nevzathipertek/color_sensor/pcb_and_electronic_design/colorSensor01-6.jpg

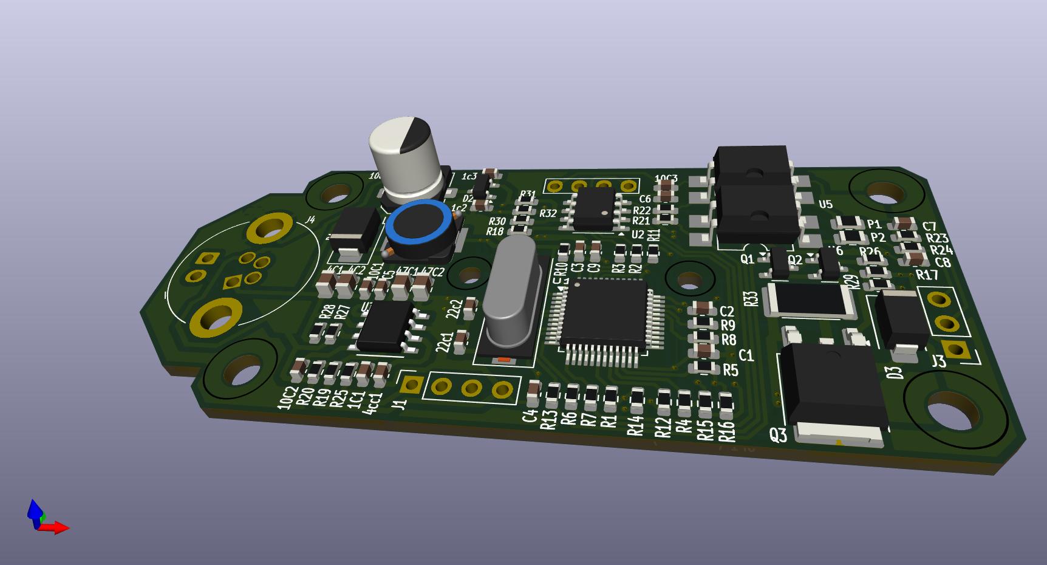
pcb_and_electronic_design/colorSensor01-6.jpg
