nevzathipertek/color_sensor/pcb_and_electronic_design/back2.jpg

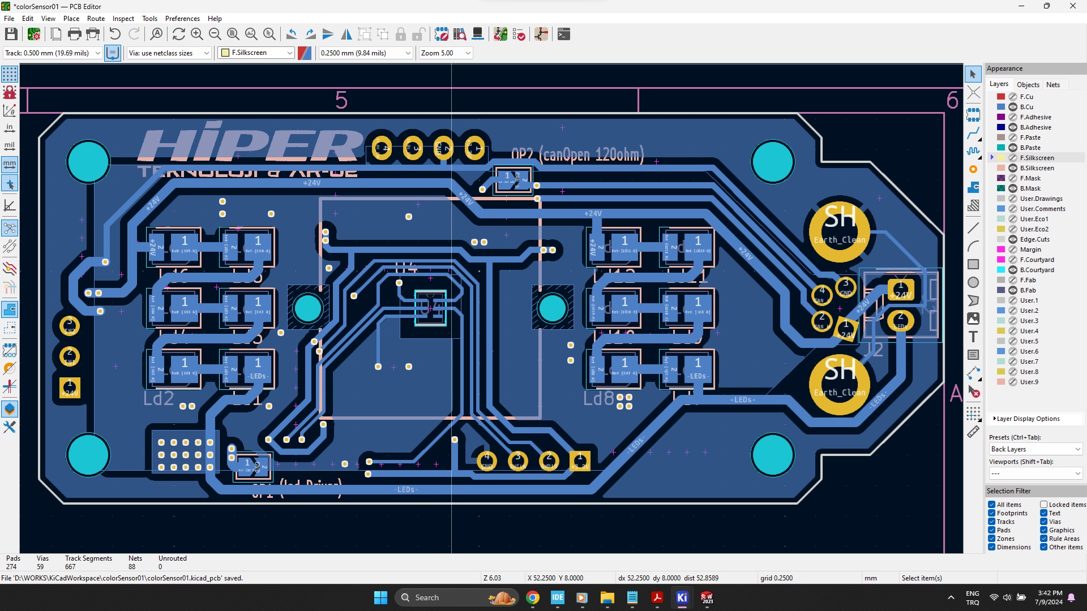
pcb_and_electronic_design/back2.jpg
