nevzathipertek/color_sensor/pcb_and_electronic_design/colorSensor01-2.jpg

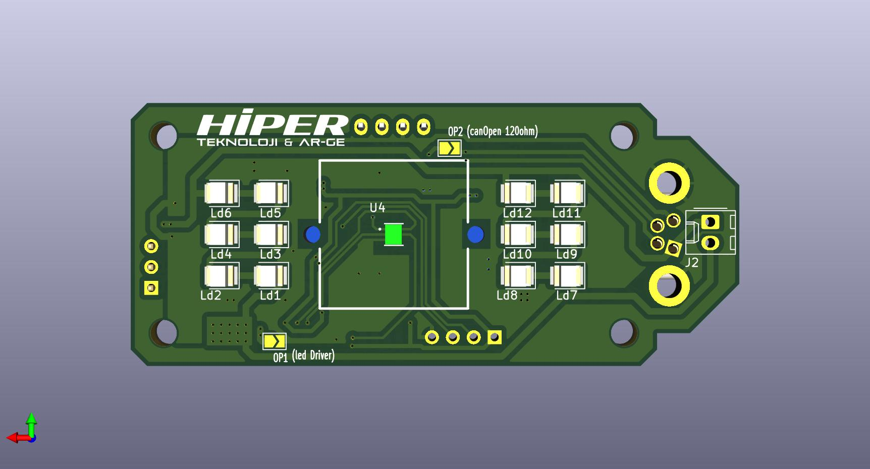
pcb_and_electronic_design/colorSensor01-2.jpg
