nevzathipertek/color_sensor/pcb_and_electronic_design/colorSensor01-4.jpg

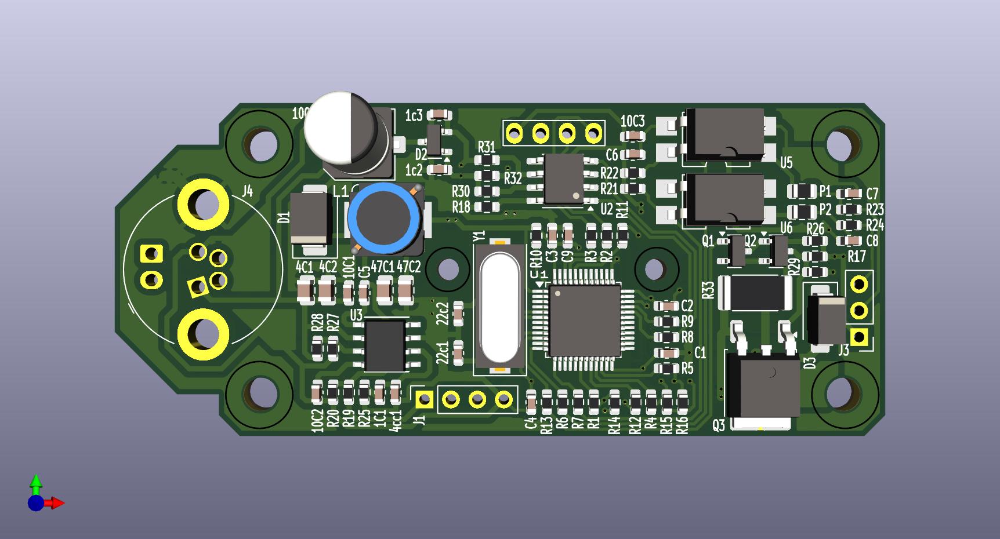
pcb_and_electronic_design/colorSensor01-4.jpg
