nevzathipertek/color_sensor/pcb_and_electronic_design/colorSensor01-5.jpg

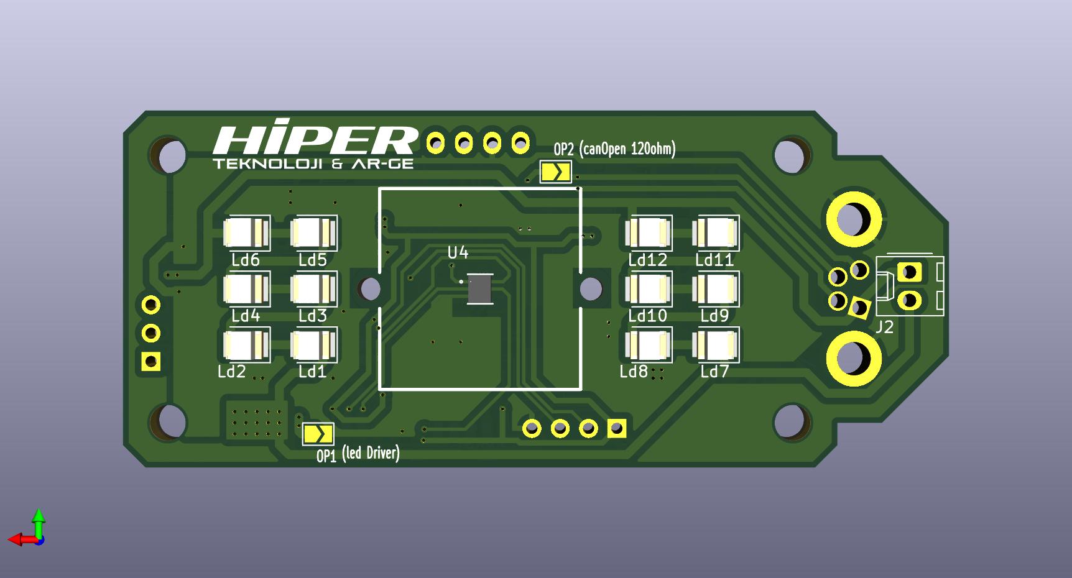
pcb_and_electronic_design/colorSensor01-5.jpg
