nevzathipertek/color_sensor/pcb_and_electronic_design/front1.jpg

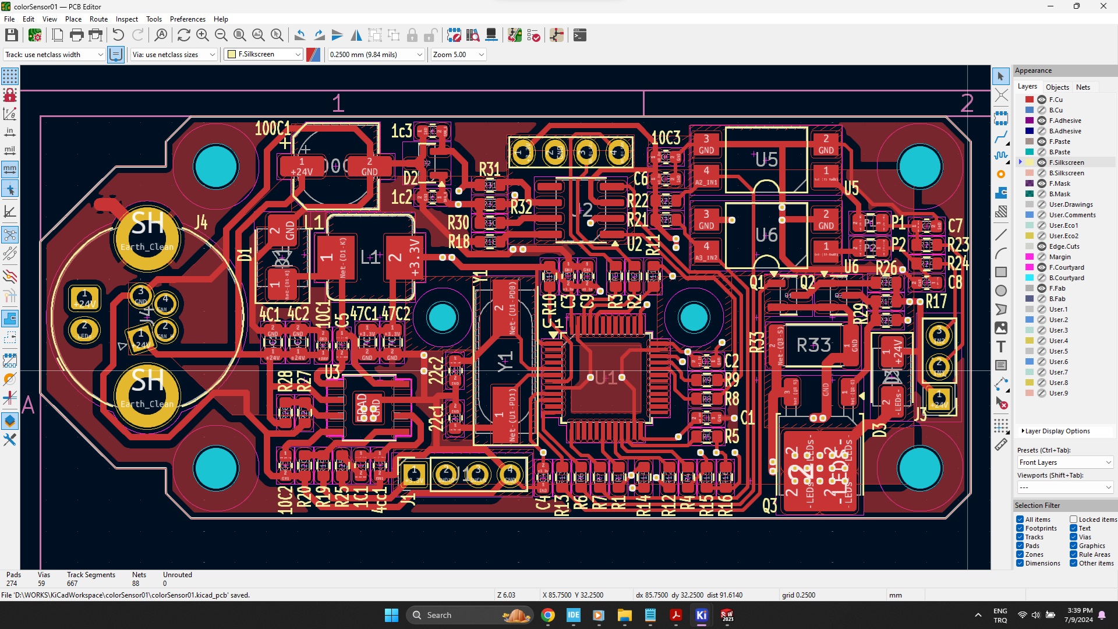
pcb_and_electronic_design/front1.jpg
