nevzathipertek/color_sensor/pcb_and_electronic_design/front3all.jpg

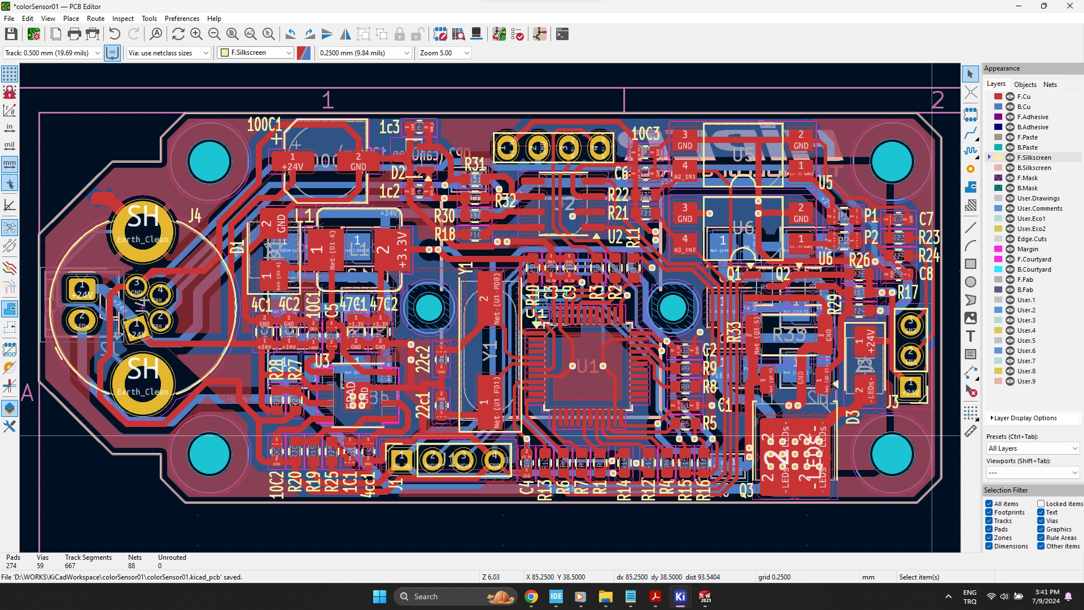
pcb_and_electronic_design/front3all.jpg
