nevzathipertek/color_sensor/pcb_and_electronic_design/schematic-colorSensor.jpg

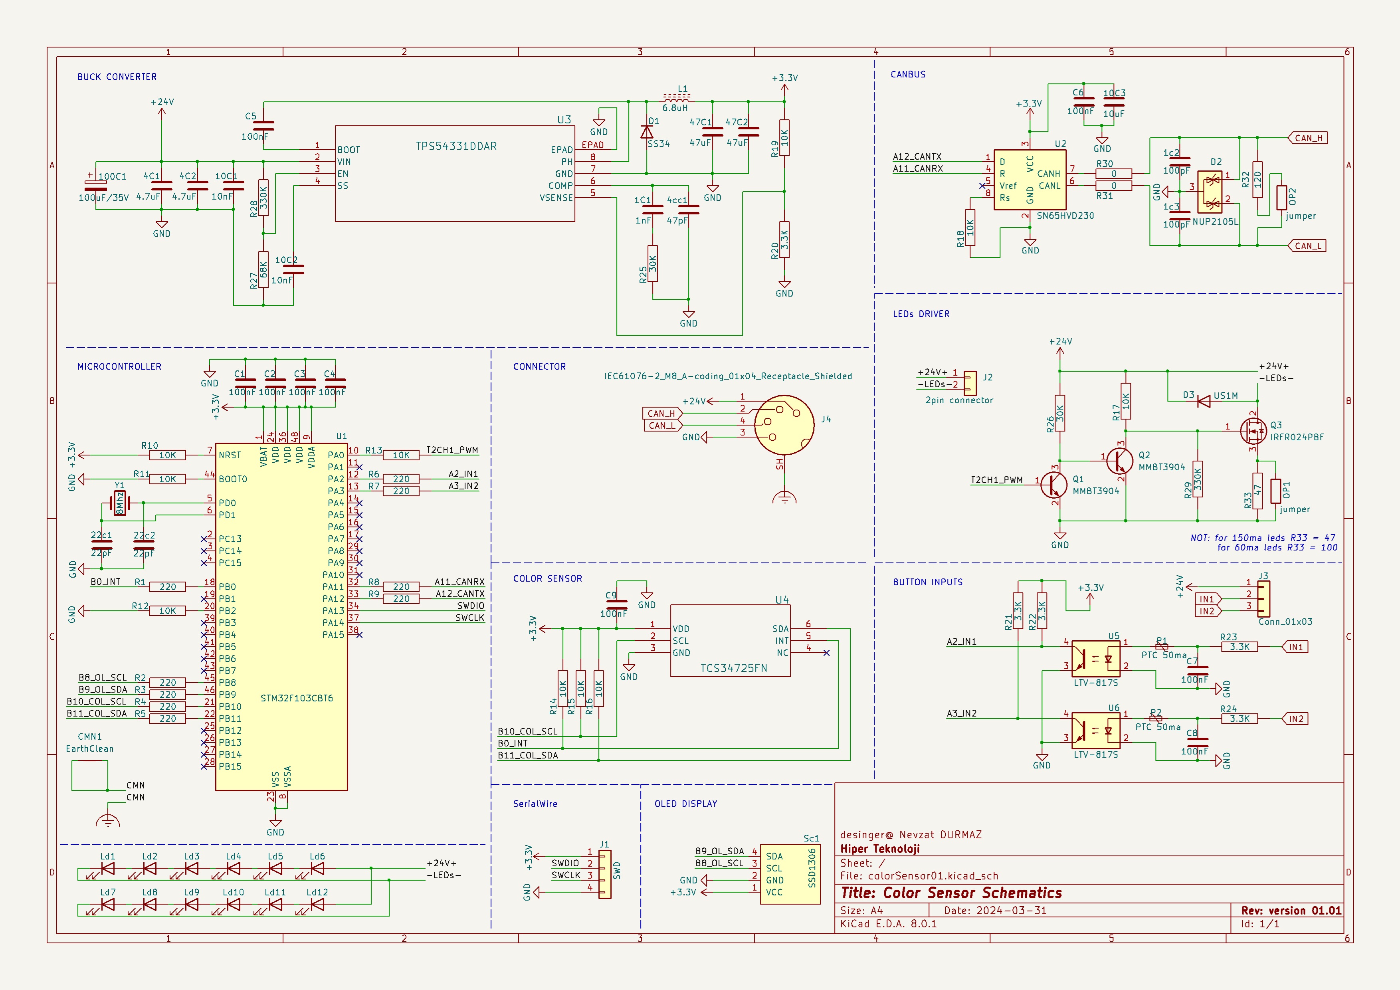
pcb_and_electronic_design/schematic-colorSensor.jpg
