nevzathipertek/color_sensor/solid_modelling/membran.jpg

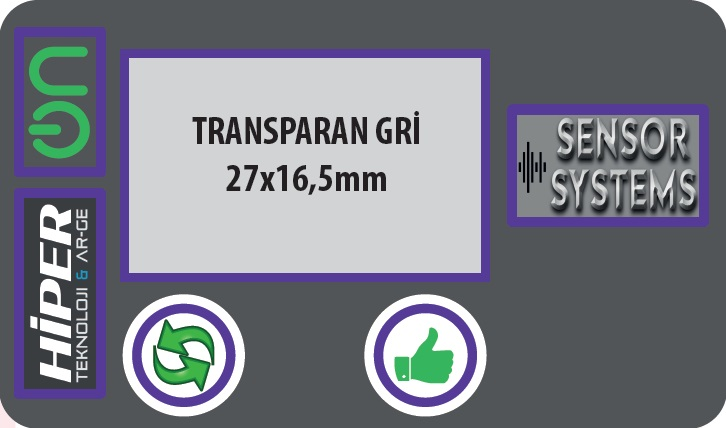
solid_modelling/membran.jpg
