nevzathipertek/color_sensor/pcb_and_electronic_design/colorSensor_BOM.xlsx

Comment | Designator | Footprint | JLCPCB Part #（optional）
PTC 50ma | P2,P1 | Fuse_0805_2012Metric | ptc fuse 50ma
10K | R16,R18,R11,R12,R10,R13,R14,R15,R19,R17 | R_0603_1608Metric
US1M | D3 | D_SMA | Diodes,
3.3K | R24,R20,R23,R21,R22 | R_0603_1608Metric
220 | R4,R3,R1,R6,R8,R5,R9,R2,R7 | R_0603_1608Metric
8Mhz | Y1 | Crystal_SMD_HC49-SD
20pF | 22c1,22c2 | C_0603_1608Metric | 20pF (or 22pF)
100nF | C4,C1,C8,C6,C2,C7,C9,C3,C5 | C_0603_1608Metric
LTV-817S | U6,U5 | SMDIP-4_W9.53mm | LITEON, Optocoupler (or PC817xxx - Diodes Incorporated, SHARP/Socle Technology )
SN65HVD230 | U2 | SOIC-8_3.9x4.9mm_P1.27mm | Texas Instruments,
NUP2105L | D2 | SOT-23 | Onsemi, or Diotec Semiconductor
0 | R31,R30 | R_0603_1608Metric | 0 ohm
TPS54331DDAR | U3 | DDA8_3X2P13-L | Texas Instruments TPS54331DDAR
68K | R27 | R_0603_1608Metric
10nF | 10C1,10C2 | C_0603_1608Metric
MMBT3904 | Q1,Q2 | SOT-23 | Onsemi,
47 | R33 | R_2512_6332Metric
47pF | 4cc1 | C_0603_1608Metric
100pF | 1c2,1c3 | C_0603_1608Metric
6.8uH | L1 | L_Bourns_SRP7028A_7.3x6.6mm | 1A or higher
10uF | 10C3 | C_0603_1608Metric
IRFR024PBF | Q3 | TO-252-2 | Vishay (or Infineon – IRFR540ZTRPBF)
STM32F103CBT6 | U1 | LQFP-48_7x7mm_P0.5mm | must be original ST
47uF | 47C2,47C1 | C_0805_2012Metric
120 | R32 | R_0603_1608Metric
30K | R25,R26 | R_0603_1608Metric
100uF/35V | 100C1 | CP_Elec_6.3x7.7 | 35V ~ 50V
4.7uF | 4C2,4C1 | C_0805_2012Metric
330K | R28,R29 | R_0603_1608Metric
SS34 | D1 | D_SMB
1nF | 1C1 | C_0603_1608Metric
LED | Ld1 – Ld12 | LED_PLCC_2835 | (2835 packet, 2.8V~3.2V, 150~200mA, 60~120degree beam angle) daylight / sunlight – large spectrum
TCS34725FN | U4 | TCS34725FN_AMS | AMS OSRAM
