nevzathipertek/color_sensor/solid_modelling/upCase.SLDPRT

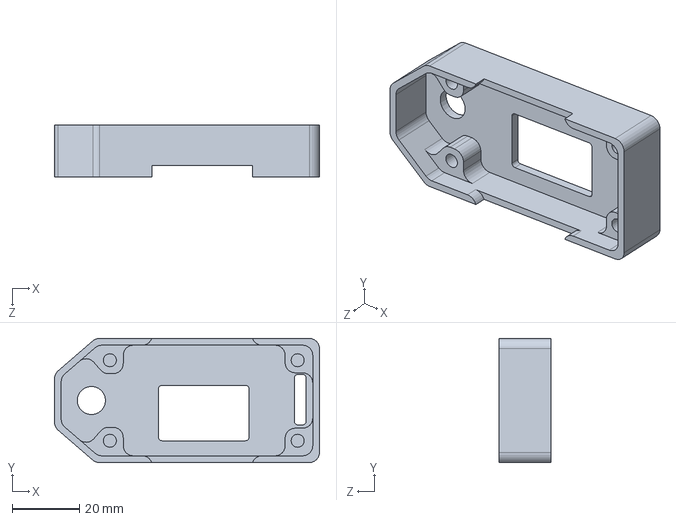
[picture p10: CAD file, 2024-07-17]
solid_modelling/upCase.SLDPRT
79.0 x 37.0 x 15.5 mm
