nevzathipertek/color_sensor/solid_modelling/downCase.SLDPRT

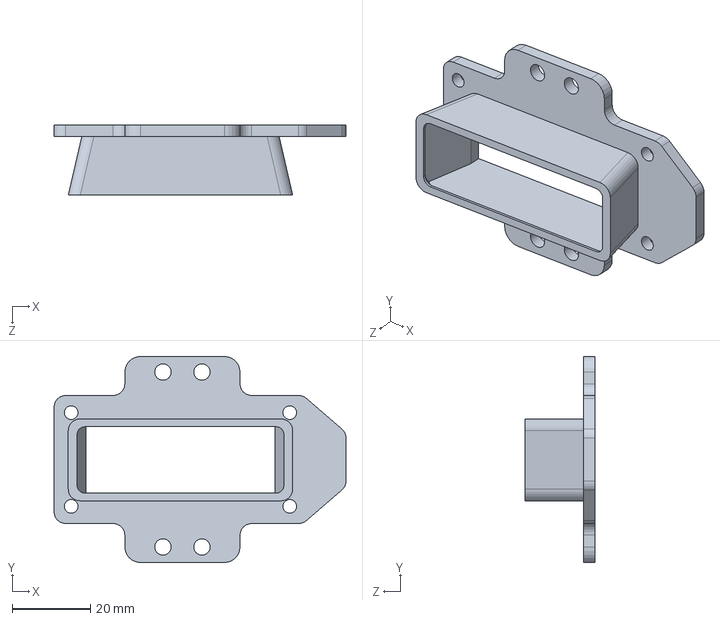
[picture p11: CAD file, 2024-07-17]
solid_modelling/downCase.SLDPRT
74.8 x 52.8 x 18.0 mm
