nevzathipertek/color_sensor/solid_modelling/membranTus.SLDPRT

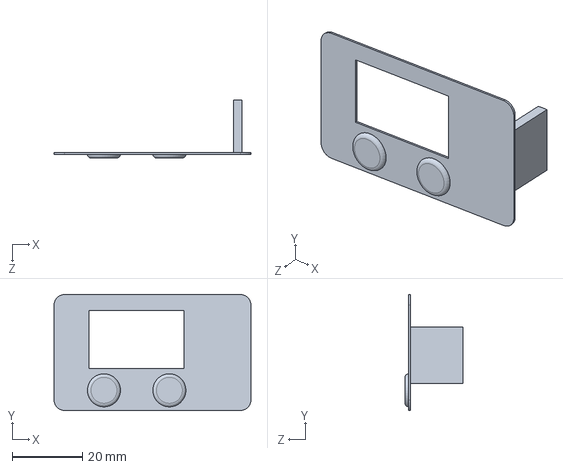
[picture p12: CAD file, 2024-07-17]
solid_modelling/membranTus.SLDPRT
56.0 x 33.0 x 16.5 mm
