nevzathipertek/color_sensor/solid_modelling/colorSensor01.step.SLDASM

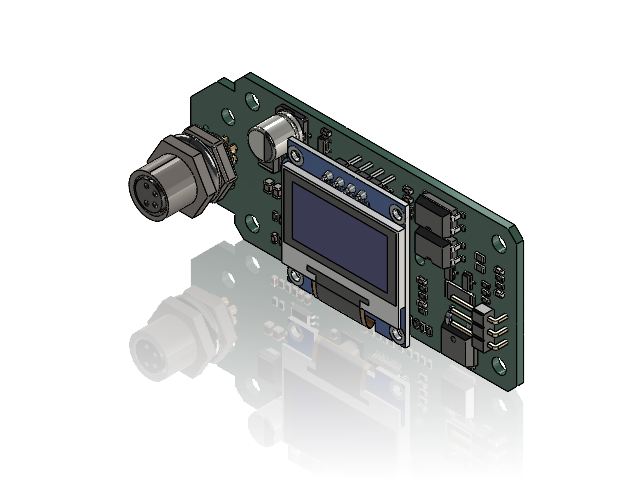
[picture p13: CAD file, 2024-07-17]
solid_modelling/colorSensor01.step.SLDASM
Fuse_0805_2012Metric-0.step x 2
R_0603_1608Metric-1.step x 32
D_SMA-2.step
Crystal_SMD_HC49-SD-3.step
C_0603_1608Metric-4.step x 18
SMDIP_4_W953mm.step x 2
SOIC_8_39x49mm_P127mm.step
SOT_23.step x 3
DDA0008H_ASM.step
R_2512_6332Metric-5.step
Sf___fd_sp.step
connectorFemaleFlange-6.step
PinHeader_1x03_P254mm_Horizontal.step
CQ assembly.step
LQFP_48_7x7mm_P05mm.step
C_0805_2012Metric-7.step x 4
(Unsaved).step
CP_Elec_63x77.step
D_SMB-8.step
LED_1210_3225Metric-9.step x 12
part.step
colorSensor01_PCB.step
