nevzathipertek/color_sensor/(list of files, cad)

Other CAD files:
solid_modelling/colorSensorParts/SMDIP-4_W9.53mm.step.SLDASM
solid_modelling/colorSensorParts/connectorFemaleFlange.step.SLDASM
solid_modelling/colorSensorParts/L_TDK_SLF7032.step.SLDASM
solid_modelling/colorSensorParts/DDA0008H.step.SLDASM
solid_modelling/colorSensorParts/D_SMB.step.SLDASM
solid_modelling/colorSensorParts/LED_1210_3225Metric.step.SLDASM
solid_modelling/colorSensorParts/CQ assembly.step.SLDPRT
solid_modelling/colorSensorParts/R_2512_6332Metric.step.SLDASM
solid_modelling/colorSensorParts/Fuse_0805_2012Metric.step.SLDASM
solid_modelling/colorSensorParts/Crystal_SMD_HC49-SD.step.SLDASM
solid_modelling/colorSensorParts/C_0805_2012Metric.step.SLDASM
solid_modelling/colorSensorParts/OLED-128x64-0.96.step.SLDASM
solid_modelling/colorSensorParts/SOIC-8_3.9x4.9mm_P1.27mm.step.SLDASM
solid_modelling/colorSensorParts/PinHeader_1x03_P2.54mm_Horizontal.step.SLDASM
solid_modelling/colorSensorParts/SOT-23.step.SLDASM
solid_modelling/colorSensorParts/LQFP-48_7x7mm_P0.5mm.step.SLDASM
solid_modelling/colorSensorParts/CP_Elec_6.3x7.7.step.SLDASM
solid_modelling/colorSensorParts/TO-252-2.step.SLDASM
solid_modelling/colorSensorParts/DDA0008H_ASM.step.SLDPRT
solid_modelling/colorSensorParts/R_0603_1608Metric.step.SLDASM
solid_modelling/colorSensorParts/D_SMA.step.SLDASM
solid_modelling/colorSensorParts/C_0603_1608Metric.step.SLDASM
solid_modelling/colorSensorParts/connectorFemaleFlange-6.step.SLDPRT
solid_modelling/colorSensorParts/Crystal_SMD_HC49-SD-3.step.SLDPRT
solid_modelling/colorSensorParts/D_SMA-2.step.SLDPRT
solid_modelling/colorSensorParts/(Unsaved).step.SLDPRT
solid_modelling/colorSensorParts/SMDIP_4_W953mm.step.SLDPRT
solid_modelling/colorSensorParts/Sf___fd_sp.step.SLDPRT
solid_modelling/colorSensorParts/SOIC_8_39x49mm_P127mm.step.SLDPRT
solid_modelling/colorSensorParts/colorSensor01_PCB.step.SLDPRT
solid_modelling/colorSensorParts/D_SMB-8.step.SLDPRT
solid_modelling/colorSensorParts/PinHeader_1x03_P254mm_Horizontal.step.SLDPRT
solid_modelling/colorSensorParts/LQFP_48_7x7mm_P05mm.step.SLDPRT
solid_modelling/colorSensorParts/LED_1210_3225Metric-9.step.SLDPRT
solid_modelling/colorSensorParts/C_0603_1608Metric-4.step.SLDPRT
solid_modelling/colorSensorParts/R_2512_6332Metric-5.step.SLDPRT
solid_modelling/colorSensorParts/Fuse_0805_2012Metric-0.step.SLDPRT
solid_modelling/colorSensorParts/R_0603_1608Metric-1.step.SLDPRT
solid_modelling/colorSensorParts/CP_Elec_63x77.step.SLDPRT
solid_modelling/colorSensorParts/C_0805_2012Metric-7.step.SLDPRT
solid_modelling/colorSensorParts/part.step.SLDPRT
solid_modelling/colorSensorParts/SOT_23.step.SLDPRT
solid_modelling/colorSensorParts/TCS34725FN_AMS.step.SLDASM
solid_modelling/downCase.STL
solid_modelling/upCase.STL
