nevzathipertek/color_sensor/pcb_and_electronic_design/colorSensor01/colorSensor01.kicad_pcb

## KiCad design pcb_and_electronic_design/colorSensor01/colorSensor01.kicad_pcb (2024-07-17)

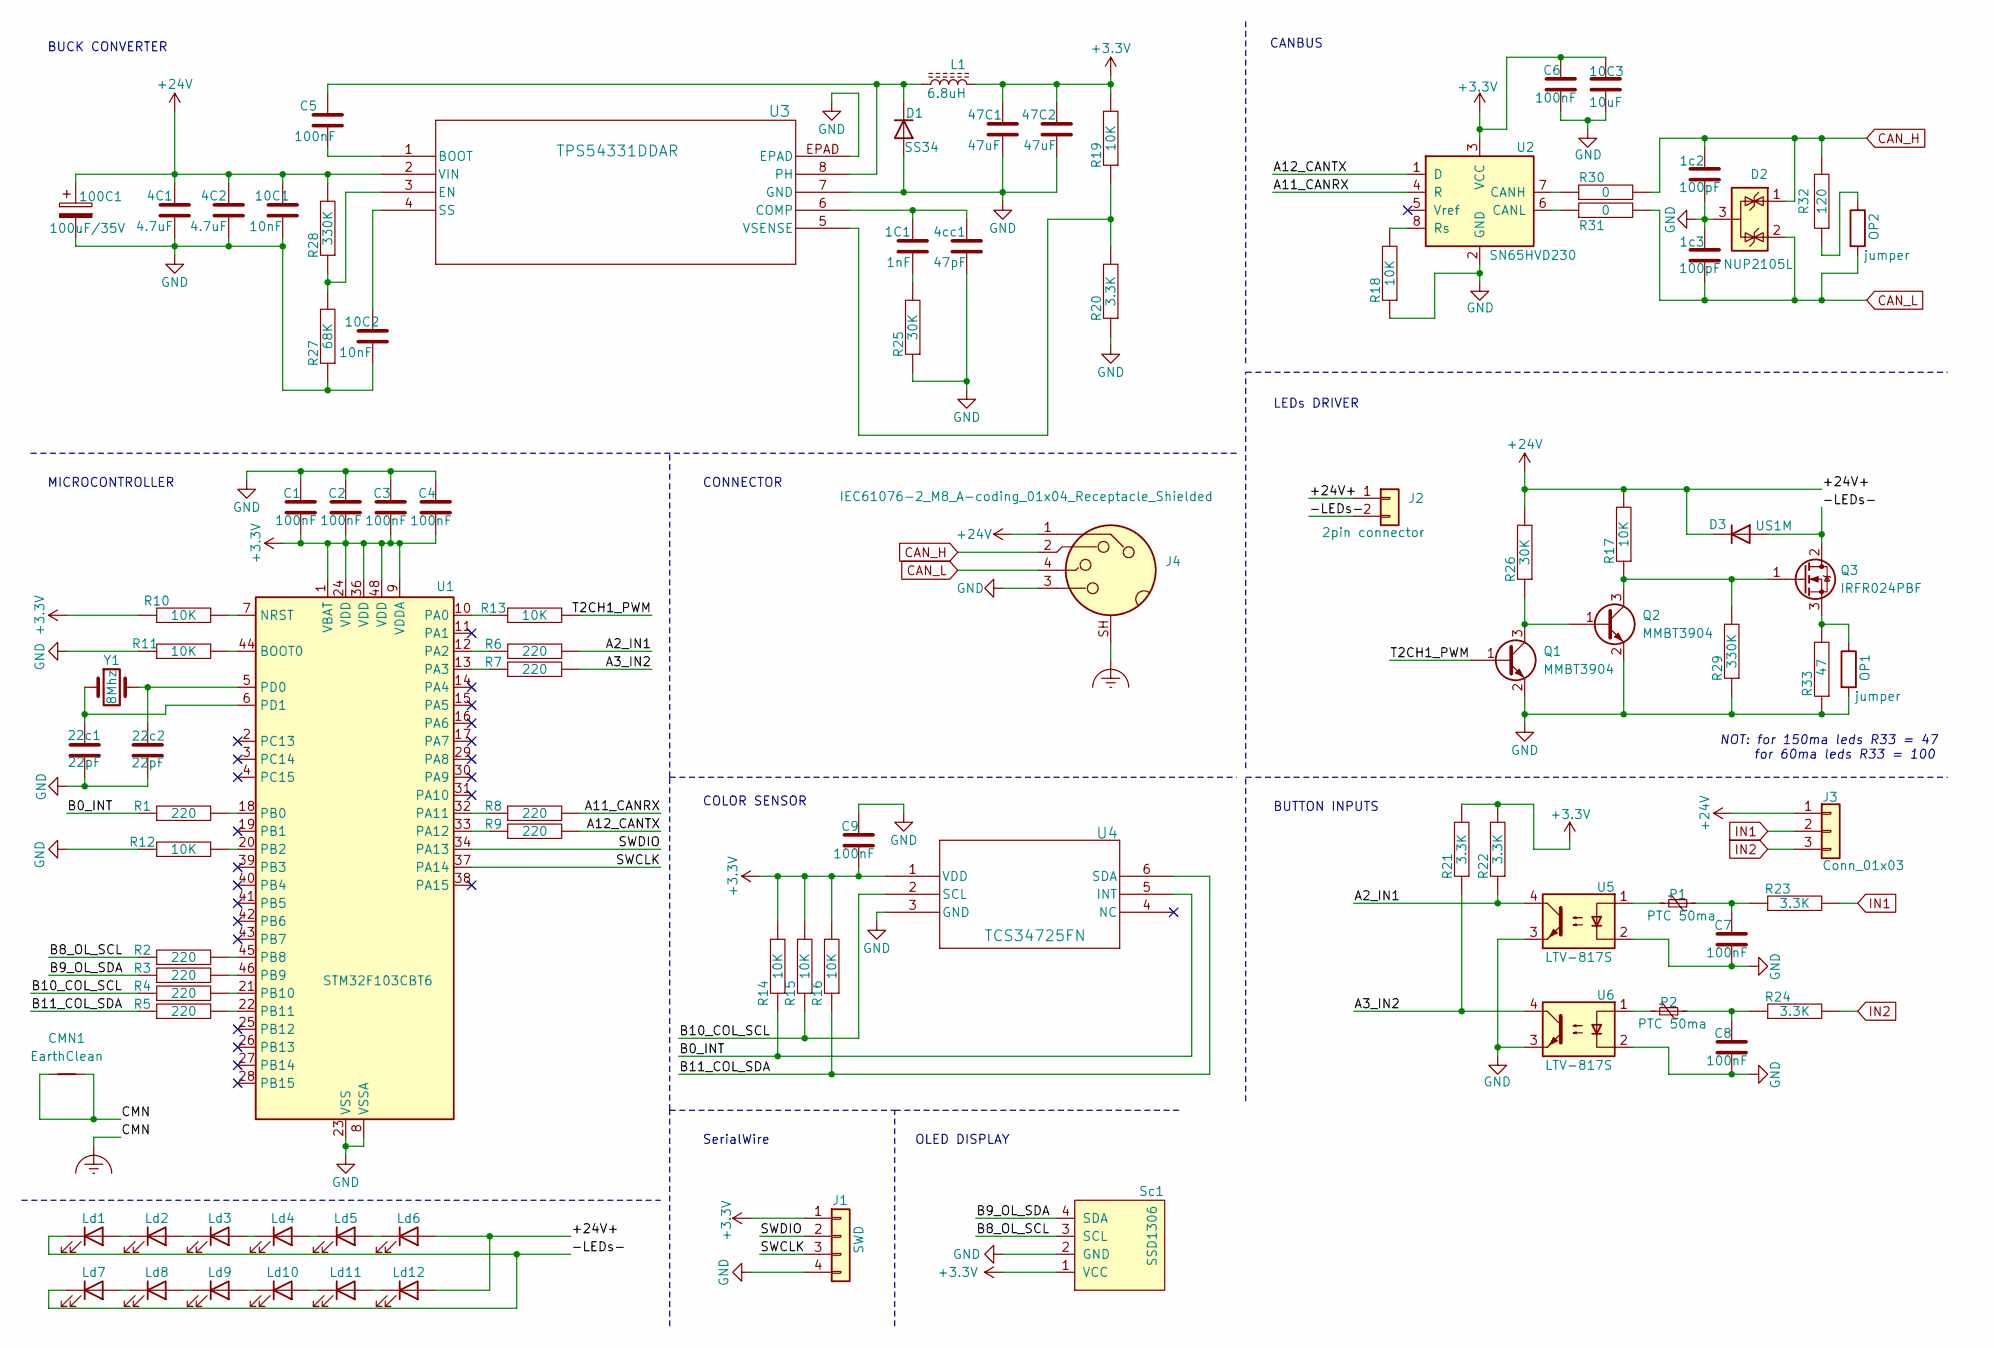
[picture p14: schematic colorSensor01.kicad_sch, Color Sensor Schematics]

Parts:
1C1: 1nF; C_0603_1608Metric
1c2, 1c3: 100pF; C_0603_1608Metric
4C1, 4C2: 4.7uF; C_0805_2012Metric
4cc1: 47pF; C_0603_1608Metric
10C1, 10C2: 10nF; C_0603_1608Metric
10C3: 10uF; C_0603_1608Metric
22c1, 22c2: 22pF; C_0603_1608Metric
47C1, 47C2: 47uF; C_0805_2012Metric
100C1: 100uF/35V; CP_Elec_6.3x7.7
C1, C2, C3, C4, C5, C6, C7, C8, C9: 100nF; C_0603_1608Metric
CMN1: EarthClean; NetTie-2_SMD_Pad0.5mm
D1: SS34; D_SMB
D2: NUP2105L; SOT-23
D3: US1M; D_SMA
J1: SWD; PinSocket_1x04_P2.54mm_Vertical
J2: 2pin connector; Molex_KK-254_AE-6410-02A_1x02_P2.54mm_Vertical
J3: Conn_01x03; PinHeader_1x03_P2.54mm_Vertical
J4: IEC61076-2_M8_A-coding_01x04_Receptacle_Shielded; TE_T4041037041-000_M8_04_Socket_Straight
L1: 6.8uH; L_Bourns_SRP7028A_7.3x6.6mm
Ld1, Ld2, Ld3, Ld4, Ld5, Ld6, Ld7, Ld8, Ld9, Ld10, Ld11, Ld12: LED; LED_PLCC_2835
OP1, OP2: jumper; SolderJumper-2_P1.3mm_Open_TrianglePad1.0x1.5mm
P1, P2: PTC 50ma; Fuse_0805_2012Metric
Q1, Q2: MMBT3904; SOT-23
Q3: IRFR024PBF; TO-252-2
R1, R2, R3, R4, R5, R6, R7, R8, R9: 220; R_0603_1608Metric
R10, R11, R12, R13, R14, R15, R16, R17, R18, R19: 10K; R_0603_1608Metric
R20, R21, R22, R23, R24: 3.3K; R_0603_1608Metric
R25, R26: 30K; R_0603_1608Metric
R27: 68K; R_0603_1608Metric
R28, R29: 330K; R_0603_1608Metric
R30, R31: 0; R_0603_1608Metric
R32: 120; R_0603_1608Metric
R33: 47; R_2512_6332Metric
Sc1: SSD1306; 128x64OLED
U1: STM32F103CBT6; LQFP-48_7x7mm_P0.5mm
U2: SN65HVD230; SOIC-8_3.9x4.9mm_P1.27mm
U3: TPS54331DDAR; DDA8_3X2P13-L
U4: TCS34725FN; TCS34725FN_AMS
U5, U6: LTV-817S; SMDIP-4_W9.53mm
Y1: 8Mhz; Crystal_SMD_HC49-SD

Connections:
+3.3V: 10C3.1, 47C1.1, 47C2.1, C1.2, C2.2, C3.2, C4.2, C6.1, C9.2, J1.1, L1.2, R10.1, R14.2, R15.2, R16.2, R19.2, R21.2, R22.2, Sc1.1 (VCC), U1.1 (VBAT), U1.9 (VDDA), U1.24 (VDD), U1.36 (VDD), U1.48 (VDD), U2.3 (VCC), U4.1 (VDD)
+24V: 4C1.1, 4C2.1, 10C1.1, 100C1.1, D3.1 (K), J2.1, J3.1, J4.1, Ld6.2 (A), Ld12.2 (A), R17.2, R26.2, R28.2, U3.2 (VIN)
/-LEDs-: D3.2 (A), J2.2, Ld1.1 (K), Ld7.1 (K), Q3.2 (D)
/A2_IN1: R6.2, R22.1, U5.4
/A3_IN2: R7.2, R21.1, U6.4
/A11_CANRX: R8.2, U2.4 (R)
/A12_CANTX: R9.2, U2.1 (D)
/B0_INT: R1.1, R14.1, U4.5 (INT)
/B8_OL_SCL: R2.1, Sc1.3 (SCL)
/B9_OL_SDA: R3.1, Sc1.4 (SDA)
/B10_COL_SCL: R4.1, R15.1, U4.2 (SCL)
/B11_COL_SDA: R5.1, R16.1, U4.6 (SDA)
/SWCLK: J1.3, U1.37 (PA14)
/SWDIO: J1.2, U1.34 (PA13)
/T2CH1_PWM: Q1.1 (B), R13.2
CAN_H: 1c2.1, D2.1 (K), J4.2, R30.2, R32.2
CAN_L: 1c3.2, D2.2 (K), J4.4, OP2.2, R31.2
Earth_Clean: CMN1.1, CMN1.2, J4.SH
GND: 1c2.2, 1c3.1, 4C1.2, 4C2.2, 4cc1.2, 10C1.2, 10C2.2, 10C3.2, 22c1.2, 22c2.2, 47C1.2, 47C2.2, 100C1.2, C1.1, C2.1, C3.1, C4.1, C6.2, C7.2, C8.2, C9.1, D1.2 (A), D2.3 (A), J1.4, J4.3, OP1.2, Q1.2 (E), Q2.2 (E), R11.1, R12.1, R18.1, R20.1, R25.1, R27.1, R29.1, R33.1, Sc1.2 (GND), U1.8 (VSSA), U1.23 (VSS), U1.35 (VSS), U1.47 (VSS), U2.2 (GND), U3.7 (GND), U3.EPAD, U4.3 (GND), U5.2, U5.3, U6.2, U6.3
IN1: J3.2, R23.2
IN2: J3.3, R24.2
unnamed: 1C1.2, R25.2
unnamed: C7.1, P1.1, R23.1
unnamed: C8.1, P2.1, R24.1
unnamed: C5.1, D1.1 (K), L1.1, U3.8 (PH)
unnamed: Ld1.2 (A), Ld2.1 (K)
unnamed: Ld2.2 (A), Ld3.1 (K)
unnamed: Ld3.2 (A), Ld4.1 (K)
unnamed: Ld4.2 (A), Ld5.1 (K)
unnamed: Ld5.2 (A), Ld6.1 (K)
unnamed: Ld7.2 (A), Ld8.1 (K)
unnamed: Ld8.2 (A), Ld9.1 (K)
unnamed: Ld10.2 (A), Ld11.1 (K)
unnamed: Ld9.2 (A), Ld10.1 (K)
unnamed: Ld11.2 (A), Ld12.1 (K)
unnamed: OP2.1, R32.1
unnamed: P1.2, U5.1
unnamed: P2.2, U6.1
unnamed: Q1.3 (C), Q2.1 (B), R26.1
unnamed: Q2.3 (C), Q3.1 (G), R17.1, R29.2
unnamed: OP1.1, Q3.3 (S), R33.2
unnamed: R11.2, U1.44 (BOOT0)
unnamed: R10.2, U1.7 (NRST)
unnamed: R13.1, U1.10 (PA0)
unnamed: R6.1, U1.12 (PA2)
unnamed: R7.1, U1.13 (PA3)
unnamed: R8.1, U1.32 (PA11)
unnamed: R9.1, U1.33 (PA12)
unnamed: R1.2, U1.18 (PB0)
unnamed: R12.2, U1.20 (PB2)
unnamed: R2.2, U1.45 (PB8)
unnamed: R3.2, U1.46 (PB9)
unnamed: R4.2, U1.21 (PB10)
unnamed: R5.2, U1.22 (PB11)
unnamed: 22c2.1, U1.5 (PD0), Y1.2
unnamed: 22c1.1, U1.6 (PD1), Y1.1
unnamed: R30.1, U2.7 (CANH)
unnamed: R31.1, U2.6 (CANL)
unnamed: R18.2, U2.8 (Rs)
unnamed: C5.2, U3.1 (BOOT)
unnamed: 1C1.1, 4cc1.1, U3.6 (COMP)
unnamed: R27.2, R28.1, U3.3 (EN)
unnamed: 10C2.1, U3.4 (SS)
unnamed: R19.1, R20.2, U3.5 (VSENSE)

Notes on the sheet:
LEDs DRIVER
OLED DISPLAY
BUCK CONVERTER
SerialWire
CONNECTOR
COLOR SENSOR
CANBUS
MICROCONTROLLER
NOT: for 150ma leds R33 = 47 for 60ma leds R33 = 100
BUTTON INPUTS

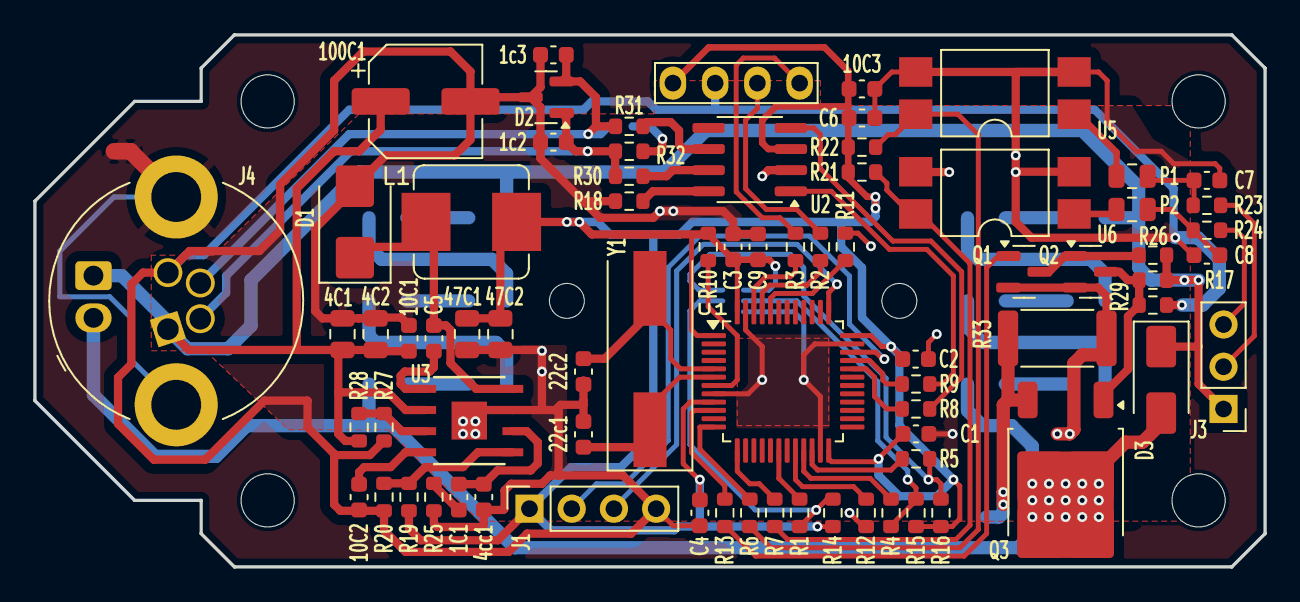
[picture p15: board colorSensor01.kicad_pcb from above]

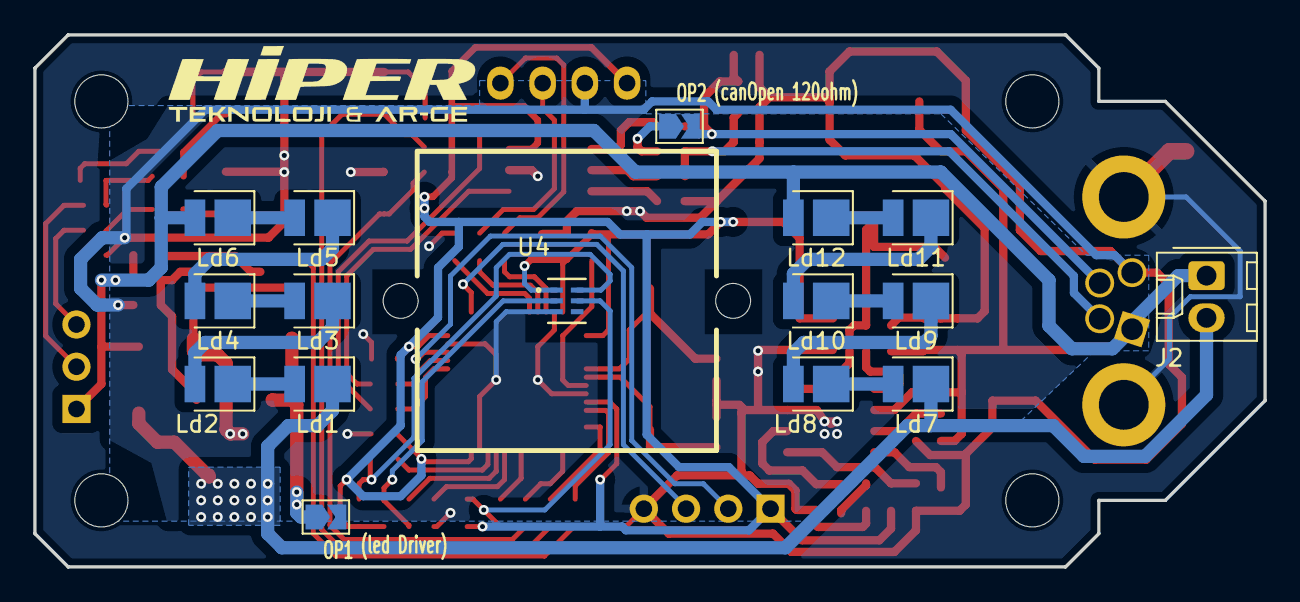
[picture p16: board colorSensor01.kicad_pcb from below]

Board: 2 copper layers, 74.0 x 32.0 mm, 99 parts (17 on the bottom side), 64 nets.

Other parts of the board:
H1, H2: MountingHole_2.1mm
H3, H4, H5, H6: MountingHole_3.2mm_M3
HİPER: LOGO
