nevzathipertek/color_sensor/code_color_sensor/colorSensor2/Core/Src/main.cpp

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
/* Includes ------------------------------------------------------------------*/
#include "main.h"
#include "cmsis_os.h"

/* USER CODE BEGIN Includes */
//--------------------------------------------------------------------//
//--------------------------------------------------------------------//
#include "PROCESS.h"
//--------------------------------------------------------------------//
//--------------------------------------------------------------------//
/* USER CODE END Includes */

typedef StaticTask_t osStaticThreadDef_t;
CAN_HandleTypeDef hcan;

I2C_HandleTypeDef hi2c2;

IWDG_HandleTypeDef hiwdg;

TIM_HandleTypeDef htim2;
TIM_HandleTypeDef htim4;

/* Definitions for ProcessingTask */
osThreadId_t ProcessingTaskHandle;
uint32_t ProcessingTaskBuffer[ 512 ];
osStaticThreadDef_t ProcessingTaskControlBlock;
const osThreadAttr_t ProcessingTask_attributes = {
  .name = "ProcessingTask",
  .cb_mem = &ProcessingTaskControlBlock,
  .cb_size = sizeof(ProcessingTaskControlBlock),
  .stack_mem = &ProcessingTaskBuffer[0],
  .stack_size = sizeof(ProcessingTaskBuffer),
  .priority = (osPriority_t) osPriorityRealtime,
};
/* Definitions for CanOpenTask */
osThreadId_t CanOpenTaskHandle;
uint32_t CanOpenTaskBuffer[ 256 ];
osStaticThreadDef_t CanOpenTaskControlBlock;
const osThreadAttr_t CanOpenTask_attributes = {
  .name = "CanOpenTask",
  .cb_mem = &CanOpenTaskControlBlock,
  .cb_size = sizeof(CanOpenTaskControlBlock),
  .stack_mem = &CanOpenTaskBuffer[0],
  .stack_size = sizeof(CanOpenTaskBuffer),
  .priority = (osPriority_t) osPriorityNormal,
};
/* Definitions for WriteScreenTask */
osThreadId_t WriteScreenTaskHandle;
uint32_t WriteScreenBuffer[ 256 ];
osStaticThreadDef_t WriteScreenControlBlock;
const osThreadAttr_t WriteScreenTask_attributes = {
  .name = "WriteScreenTask",
  .cb_mem = &WriteScreenControlBlock,
  .cb_size = sizeof(WriteScreenControlBlock),
  .stack_mem = &WriteScreenBuffer[0],
  .stack_size = sizeof(WriteScreenBuffer),
  .priority = (osPriority_t) osPriorityLow,
};
/* Definitions for ReadButtons */
osThreadId_t ReadButtonsHandle;
uint32_t ReadButtonsBuffer[ 128 ];
osStaticThreadDef_t ReadButtonsControlBlock;
const osThreadAttr_t ReadButtons_attributes = {
  .name = "ReadButtons",
  .cb_mem = &ReadButtonsControlBlock,
  .cb_size = sizeof(ReadButtonsControlBlock),
  .stack_mem = &ReadButtonsBuffer[0],
  .stack_size = sizeof(ReadButtonsBuffer),
  .priority = (osPriority_t) osPriorityBelowNormal,
};
void SystemClock_Config(void);
static void MX_GPIO_Init(void);
static void MX_CAN_Init(void);
static void MX_I2C2_Init(void);
static void MX_IWDG_Init(void);
static void MX_TIM2_Init(void);
static void MX_TIM4_Init(void);
void StartProcessingTask(void *argument);
void StartCanOpenTask(void *argument);
void StartWriteScreenTask(void *argument);
void StartReadButtonsTask(void *argument);

/* USER CODE BEGIN PFP */
//--------------------------------------------------------------------//
//--------------------------------------------------------------------//
PROCESS pr{ MX_CAN_Init };
//--------------------------------------------------------------------//
//--------------------------------------------------------------------//
/* USER CODE END PFP */

/**
  * @brief  The application entry point.
  * @retval int
  */
int main(void)
{

  /* MCU Configuration--------------------------------------------------------*/

  /* Reset of all peripherals, Initializes the Flash interface and the Systick. */
  HAL_Init();

  /* Configure the system clock */
  SystemClock_Config();

  /* Initialize all configured peripherals */
  MX_GPIO_Init();
  MX_CAN_Init();
  MX_I2C2_Init();
  MX_IWDG_Init();
  MX_TIM2_Init();
  MX_TIM4_Init();
  /* USER CODE BEGIN 2 */
  pr.init();
  /* USER CODE END 2 */

  /* Init scheduler */
  osKernelInitialize();

  /* USER CODE BEGIN RTOS_MUTEX */
  /* add mutexes, ... */
  /* USER CODE END RTOS_MUTEX */

  /* USER CODE BEGIN RTOS_SEMAPHORES */
  /* add semaphores, ... */
  /* USER CODE END RTOS_SEMAPHORES */

  /* USER CODE BEGIN RTOS_TIMERS */
  /* start timers, add new ones, ... */
  /* USER CODE END RTOS_TIMERS */

  /* USER CODE BEGIN RTOS_QUEUES */
  /* add queues, ... */
  /* USER CODE END RTOS_QUEUES */

  /* Create the thread(s) */
  /* creation of ProcessingTask */
  ProcessingTaskHandle = osThreadNew(StartProcessingTask, NULL, &ProcessingTask_attributes);

  /* creation of CanOpenTask */
  CanOpenTaskHandle = osThreadNew(StartCanOpenTask, NULL, &CanOpenTask_attributes);

  /* creation of WriteScreenTask */
  WriteScreenTaskHandle = osThreadNew(StartWriteScreenTask, NULL, &WriteScreenTask_attributes);

  /* creation of ReadButtons */
  ReadButtonsHandle = osThreadNew(StartReadButtonsTask, NULL, &ReadButtons_attributes);

  /* USER CODE BEGIN RTOS_THREADS */
  /* add threads, ... */
  /* USER CODE END RTOS_THREADS */

  /* USER CODE BEGIN RTOS_EVENTS */
  /* add events, ... */
  /* USER CODE END RTOS_EVENTS */

  /* Start scheduler */
  osKernelStart();

  /* We should never get here as control is now taken by the scheduler */

  /* Infinite loop */
  /* USER CODE BEGIN WHILE */
  while (1)
  {
    /* USER CODE END WHILE */

    /* USER CODE BEGIN 3 */
  }
  /* USER CODE END 3 */
}

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
/* USER CODE BEGIN 4 */
extern "C"
void HAL_GPIO_EXTI_Callback(uint16_t GPIO_Pin){
	if ( GPIO_Pin == COLOR_INT_B0_Pin ) {
		pr.col.updateDataInt();
	}
}
/* USER CODE END 4 */

/* USER CODE BEGIN Header_StartProcessingTask */
/**
  * @brief  Function implementing the ProcessingTask thread.
  * @param  argument: Not used
  * @retval None
  */
/* USER CODE END Header_StartProcessingTask */
void StartProcessingTask(void *argument)
{
  /* USER CODE BEGIN 5 */
  /* Infinite loop */
  for(;;)
  {
	  pr.processing();
	  osDelay(20);
  }
  /* USER CODE END 5 */
}

/* USER CODE BEGIN Header_StartCanOpenTask */
/**
* @brief Function implementing the CanOpenTask thread.
* @param argument: Not used
* @retval None
*/
/* USER CODE END Header_StartCanOpenTask */
void StartCanOpenTask(void *argument)
{
  /* USER CODE BEGIN StartCanOpenTask */
  /* Infinite loop */
  for(;;)
  {
	  canopen_app_process();
	  osDelay(10);
  }
  /* USER CODE END StartCanOpenTask */
}

/* USER CODE BEGIN Header_StartWriteScreenTask */
/**
* @brief Function implementing the WriteScreenTask thread.
* @param argument: Not used
* @retval None
*/
/* USER CODE END Header_StartWriteScreenTask */
void StartWriteScreenTask(void *argument)
{
  /* USER CODE BEGIN StartWriteScreenTask */
  /* Infinite loop */
  for(;;)
  {
	  // call every 20ms
	  pr.WriteScreenSequence();
	  osDelay(20);
  }
  /* USER CODE END StartWriteScreenTask */
}

/* USER CODE BEGIN Header_StartReadButtonsTask */
/**
* @brief Function implementing the ReadButtons thread.
* @param argument: Not used
* @retval None
*/
/* USER CODE END Header_StartReadButtonsTask */
void StartReadButtonsTask(void *argument)
{
  /* USER CODE BEGIN StartReadButtonsTask */
  /* Infinite loop */
  for(;;)
  {
	  // call every 20ms
	  pr.bt.catchPressedButton();
	  osDelay(20);
  }
  /* USER CODE END StartReadButtonsTask */
}

/**
  * @brief  Period elapsed callback in non blocking mode
  * @note   This function is called  when TIM1 interrupt took place, inside
  * HAL_TIM_IRQHandler(). It makes a direct call to HAL_IncTick() to increment
  * a global variable "uwTick" used as application time base.
  * @param  htim : TIM handle
  * @retval None
  */
void HAL_TIM_PeriodElapsedCallback(TIM_HandleTypeDef *htim)
{
  /* USER CODE BEGIN Callback 0 */

	if (htim == &htim4) {

		canopen_app_interrupt();
	}
	else
  /* USER CODE END Callback 0 */
  if (htim->Instance == TIM1) {
    HAL_IncTick();
  }
}

/**
  * @brief  This function is executed in case of error occurrence.
  * @retval None
  */
void Error_Handler(void)
{
  /* USER CODE BEGIN Error_Handler_Debug */
  /* User can add his own implementation to report the HAL error return state */
  __disable_irq();
  while (1)
  {
	  HAL_NVIC_SystemReset();
  }
  /* USER CODE END Error_Handler_Debug */
}

#ifdef  USE_FULL_ASSERT
/**
  * @brief  Reports the name of the source file and the source line number
  *         where the assert_param error has occurred.
  * @param  file: pointer to the source file name
  * @param  line: assert_param error line source number
  * @retval None
  */
void assert_failed(uint8_t *file, uint32_t line)
{
  /* USER CODE BEGIN 6 */
  /* User can add his own implementation to report the file name and line number,
     ex: printf("Wrong parameters value: file %s on line %d\r\n", file, line) */
  /* USER CODE END 6 */
}
#endif /* USE_FULL_ASSERT */
