nevzathipertek/color_sensor/code_color_sensor/colorSensor2/colorSensor2.ioc

Mcu.UserName=STM32F103CBTx
PA0-WKUP.Signal=S_TIM2_CH1_ETR
PA11.Signal=CAN_RX
PA12.Signal=CAN_TX
PA13.Signal=SYS_JTMS-SWDIO
PA14.Signal=SYS_JTCK-SWCLK
PA2.GPIO_Label=BUTTON1
PA2.Signal=GPIO_Input
PA3.GPIO_Label=BUTTON2
PA3.Signal=GPIO_Input
PB0.GPIO_Label=COLOR_INT_B0
PB0.Signal=GPXTI0
PB10.Signal=I2C2_SCL
PB11.Signal=I2C2_SDA
PB2.Signal=GPIO_Output
PB8.GPIO_Label=OLED_SCL
PB8.Signal=GPIO_Output
PB9.GPIO_Label=OLED_SDA
PB9.Signal=GPIO_Output
PD0-OSC_IN.Signal=RCC_OSC_IN
PD1-OSC_OUT.Signal=RCC_OSC_OUT
