nevzathipertek/color_sensor/code_color_sensor/colorSensor2/Core/Inc/main.h

#define BUTTON1_Pin GPIO_PIN_2
#define BUTTON1_GPIO_Port GPIOA
#define BUTTON2_Pin GPIO_PIN_3
#define BUTTON2_GPIO_Port GPIOA
#define COLOR_INT_B0_Pin GPIO_PIN_0
#define COLOR_INT_B0_GPIO_Port GPIOB
#define COLOR_INT_B0_EXTI_IRQn EXTI0_IRQn
#define OLED_SCL_Pin GPIO_PIN_8
#define OLED_SCL_GPIO_Port GPIOB
#define OLED_SDA_Pin GPIO_PIN_9
#define OLED_SDA_GPIO_Port GPIOB
