nevzathipertek/color_sensor/code_color_sensor/colorSensor2/Core/Inc/OLED_font.h

//program::oled_i2c ASCII codes file
// @uthor::Nevzat DURMAZ
//   date::25.06.2015
//version::01.00
//--------------------------------------------------------------------//
//--------------------------------------------------------------------//
#ifndef OLED_FONT_H
#define OLED_FONT_H
//--------------------------------------------------------------------//
#ifdef __cplusplus
extern "C"
{
#endif
//--------------------------------------------------------------------//
//--------------------------------------------------------------------//
namespace hiper {
//--------------------------------------------------------------------//
//--------------------------------------------------------------------//
const unsigned char F6x8[][6] =
{
   0x00, 0x00, 0x00, 0x00, 0x00, 0x00,// sp
   0x00, 0x00, 0x00, 0x2f, 0x00, 0x00,// !
   0x00, 0x00, 0x07, 0x00, 0x07, 0x00,// "
   0x00, 0x14, 0x7f, 0x14, 0x7f, 0x14,// #
   0x00, 0x24, 0x2a, 0x7f, 0x2a, 0x12,// $
   0x00, 0x62, 0x64, 0x08, 0x13, 0x23,// %
   0x00, 0x36, 0x49, 0x55, 0x22, 0x50,// &
   0x00, 0x00, 0x05, 0x03, 0x00, 0x00,// '
   0x00, 0x00, 0x1c, 0x22, 0x41, 0x00,// (
   0x00, 0x00, 0x41, 0x22, 0x1c, 0x00,// )
   0x00, 0x14, 0x08, 0x3E, 0x08, 0x14,// *
   0x00, 0x08, 0x08, 0x3E, 0x08, 0x08,// +
   0x00, 0x00, 0x00, 0xA0, 0x60, 0x00,// ,
   0x00, 0x08, 0x08, 0x08, 0x08, 0x08,// -
   0x00, 0x00, 0x60, 0x60, 0x00, 0x00,// .
   0x00, 0x20, 0x10, 0x08, 0x04, 0x02,// /
   0x00, 0x3E, 0x51, 0x49, 0x45, 0x3E,// 0
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
  0x00,0x70,0x48,0x08,0x08,0x08,0xF0,0x00,0x00,0x00,0x00,0x30,0x36,0x01,0x00,0x00,//? 31
  0xC0,0x30,0xC8,0x28,0xE8,0x10,0xE0,0x00,0x07,0x18,0x27,0x24,0x23,0x14,0x0B,0x00,//@ 32
  0x00,0x00,0xC0,0x38,0xE0,0x00,0x00,0x00,0x20,0x3C,0x23,0x02,0x02,0x27,0x38,0x20,//A 33
  0x08,0xF8,0x88,0x88,0x88,0x70,0x00,0x00,0x20,0x3F,0x20,0x20,0x20,0x11,0x0E,0x00,//B 34
  0xC0,0x30,0x08,0x08,0x08,0x08,0x38,0x00,0x07,0x18,0x20,0x20,0x20,0x10,0x08,0x00,//C 35
  0x08,0xF8,0x08,0x08,0x08,0x10,0xE0,0x00,0x20,0x3F,0x20,0x20,0x20,0x10,0x0F,0x00,//D 36
  0x08,0xF8,0x88,0x88,0xE8,0x08,0x10,0x00,0x20,0x3F,0x20,0x20,0x23,0x20,0x18,0x00,//E 37
  0x08,0xF8,0x88,0x88,0xE8,0x08,0x10,0x00,0x20,0x3F,0x20,0x00,0x03,0x00,0x00,0x00,//F 38
  0xC0,0x30,0x08,0x08,0x08,0x38,0x00,0x00,0x07,0x18,0x20,0x20,0x22,0x1E,0x02,0x00,//G 39
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
};
//--------------------------------------------------------------------//
//--------------------------------------------------------------------//
//--------------------------------------------------------------------//
//--------------------------------------------------------------------//
} /* namespace hiper */
//--------------------------------------------------------------------//
//--------------------------------------------------------------------//
//--------------------------------------------------------------------//
//--------------------------------------------------------------------//
//--------------------------------------------------------------------//
#ifdef __cplusplus
}
#endif

#endif
