nevzathipertek/color_sensor/(notices)

Notices in the files:
code_color_sensor/colorSensor2/Core/Inc/main.h:
Copyright (c) 2024 STMicroelectronics.
All rights reserved.
This software is licensed under terms that can be found in the LICENSE file
